markk/loeffler-h/src/sketch.ino

/*
 * Motor control for stepper half turns
 */

// motor pins
#define stepPin         9
#define dirPin          7
#define enablePin       5
#define alarmPin        3
#define sensorPin      11
#define ledPin         13
#define idmsbPin       A0
#define idlsbPin       A1

// speeds
#define pulseWidth      5 // microseconds
#define enableDelay    10 // milliseconds
#define halfTurnSteps 200 // steps for a half turn
#define accelSteps     90 // number of steps accelerating
#define decelLook      20 // start looking for sensor this many steps early
#define minPulse      412 // microseconds
#define maxPulse     2300 // microseconds

// duration correction
#define minimumDuration    50 // milliseconds
#define timedTurnMul        0.9907
#define timedTurnAdd       -8
#define durationGlissMul    0.9332
#define durationGlissAdd -283
#define doubleGlissMul      0.9144
#define doubleGlissAdd   -331
// pitch correction
#define glissAdd           -0.45

/*************************
 * communication commands
 *************************
 */
#define sAcknowledge    4
#define sAlarm          5
#define sReady          6
#define rEOM            0
#define rQuery          2
#define rTurn           3
#define rGliss          4
#define rTimedTurn      5
#define rDurationTurn   6
#define rDurationGliss  7
#define rForwards       8
#define rBackwards      9
#define rRecentre      10
#define rNoRecentre    11
#define rSetDuration   12
#define rReset         13
#define rDoubleGliss   14
#define rSetSustain    15
#define rTurnUntilNext 16
// array sizes
#define rDurlength      5
#define rLength        25
/*
 * ranges:
    21-39  set halfturns
    40-112 set startpitch
   120-192 set endpitch
   203-211 tests
 */

byte id;
char serialIncoming[rLength];
char newDuration[rDurlength];
char newSustainDuration[rDurlength];
int halfTurns;
long Duration;
long midDuration;
long sustainDuration;
float startPitch;
float midPitch;
float endPitch;
boolean Dir;
boolean reCentre;
volatile boolean alarmState = false;

void setup() {
    pinMode(stepPin, OUTPUT);
    pinMode(dirPin, OUTPUT);
    pinMode(enablePin, OUTPUT);
    pinMode(ledPin, OUTPUT);
    pinMode(alarmPin, INPUT_PULLUP);
    pinMode(sensorPin, INPUT_PULLUP);
    pinMode(idmsbPin, INPUT_PULLUP);
    pinMode(idlsbPin, INPUT_PULLUP);
    digitalWrite(dirPin, HIGH);
    digitalWrite(enablePin, LOW);
    attachInterrupt(digitalPinToInterrupt(alarmPin), setAlarm, CHANGE);
    Serial.begin(38400);
    findSensor(maxPulse);
    defaults();
    sendReady();
}

void setAlarm() {
    if (digitalRead(alarmPin) == LOW) {
        alarmState = true;
    } else {
        alarmState = false;
    }
}

void toggleEnable() {
    Serial.write(sAlarm);
    digitalWrite(ledPin, HIGH);
    digitalWrite(enablePin, HIGH);
    delay(enableDelay);
    digitalWrite(enablePin, LOW);
    while (alarmState) delay(enableDelay);
    digitalWrite(ledPin, LOW);
}

void defaults() {
    id = (digitalRead(idmsbPin) * 2) + digitalRead(idlsbPin);
    halfTurns = 1;
    Duration = 500;
    midDuration = 500;
    sustainDuration = 50;
    startPitch = 72;
    midPitch = 48;
    endPitch = 60;
    Dir = true;
    reCentre = true;
}

void sendReady() {
    Serial.write(sReady + id);
}

int pitchToPulse(float pitch) {
    /* map MIDI pitch to motor pulse duration */
    float i = pitch - 71;
    float p = 1 - log10((i / 51.035) + 1);
    return max(minPulse, (pow(p, 4.8) * 700) - 260);
}

float pitchbyteToMidi(byte pitch) {
    return (pitch / 2.0) + 36;
}

void oneStep(unsigned long pulseTime) {
    digitalWrite(stepPin, HIGH);
    delayMicroseconds(pulseWidth);
    digitalWrite(stepPin, LOW);
    while (pulseTime > 16383) {
        pulseTime -= 1000;
        delay(1);
    }
    delayMicroseconds(pulseTime - pulseWidth);
}

void findSensor(int pulse) {
    while(digitalRead(sensorPin) == LOW) {
        oneStep(pulse);
        if (alarmState) return;
    }
}

void turn(int halfturns, float pitch, bool dir) {
    int fullspeedsteps = (halfTurnSteps * halfturns) - (accelSteps * 2);
    int pulse = pitchToPulse(pitch);
    int startstoppulse = max(maxPulse, pulse);
    digitalWrite(dirPin, dir);
    delayMicroseconds(pulseWidth);
    for (int i=0; i<accelSteps; i++) {
        oneStep(map(i, 0, accelSteps, startstoppulse, pulse));
        if (alarmState) return;
    }
    for (int i=0; i<fullspeedsteps; i++) {
        oneStep(pulse);
        if (alarmState) return;
    }
    for (int i=0; i<accelSteps; i++) {
        oneStep(map(i, 0, accelSteps, pulse, startstoppulse));
        if (i>(accelSteps - decelLook) && digitalRead(sensorPin)) return;
        if (alarmState) return;
    }
    findSensor(startstoppulse);
}

void turnUntilNext(float pitch, bool dir) {
    int pulse = pitchToPulse(pitch);
    int startstoppulse = max(maxPulse, pulse);
    int accelsteps = map(pitch, 48, 72, accelSteps-10, accelSteps+10);
    digitalWrite(dirPin, dir);
    delayMicroseconds(pulseWidth);
    for (int i=0; i<accelsteps; i++) {
        oneStep(map(i, 0, accelsteps, startstoppulse, pulse));
        if (alarmState) return;
    }
    sendReady();
    while (Serial.available() == 0) {
        oneStep(pulse);
        if (alarmState) return;
    }
    for (int i=0; i<accelsteps; i++) {
        oneStep(map(i, 0, accelsteps, pulse, startstoppulse));
        if (alarmState) return;
    }
}

void gliss(int halfturns, float startpitch, float endpitch, bool dir) {
    int glisssteps = (halfTurnSteps * halfturns) - (accelSteps * 2);
    int startpulse = pitchToPulse(startpitch + glissAdd);
    int endpulse = pitchToPulse(endpitch + glissAdd);
    int accelsteps = map(startpitch, 48, 72, accelSteps-10, accelSteps+10);
    int decelsteps = map(endpitch, 48, 72, accelSteps-10, accelSteps+10);
    digitalWrite(dirPin, dir);
    delayMicroseconds(pulseWidth);
    for (int i=0; i<accelsteps; i++) {
        oneStep(map(i, 0, accelsteps, max(maxPulse, startpulse), startpulse));
        if (alarmState) return;
    }
    for (int i=0; i<glisssteps; i++) {
        oneStep(map(i, 0, glisssteps, startpulse, endpulse));
        if (alarmState) return;
    }
    for (int i=0; i<decelsteps; i++) {
        oneStep(map(i, 0, decelsteps, endpulse, max(maxPulse, endpulse)));
        if (i>(accelSteps - decelLook) && digitalRead(sensorPin)) return;
        if (alarmState) return;
    }
    findSensor(max(maxPulse, endpulse));
}

int timedTurn(int halfturns, long duration, bool dir) {
    // adjust duration
    duration = (duration + timedTurnAdd) * timedTurnMul;
    if (duration < minimumDuration)
        return 0;
    int fullspeedsteps = (halfTurnSteps * halfturns) - (accelSteps * 2);
    long acceltime = (long)maxPulse * (long)accelSteps;
    long turnduration = (duration * 1000L) - acceltime;
    long pulse = turnduration / (accelSteps + fullspeedsteps);
    int accelsteps = accelSteps;
    if (pulse > maxPulse) {
        accelsteps = 0;
        fullspeedsteps = halfTurnSteps * halfturns;
        pulse = (duration * 1000L) / fullspeedsteps;
    } else {
        pulse = max(pulse, minPulse);
    }
    digitalWrite(dirPin, dir);
    delayMicroseconds(pulseWidth);
    for (int i=0; i<accelsteps; i++) {
        oneStep(map(i, 0, accelsteps, maxPulse, pulse));
        if (alarmState) return 0;
    }
    for (int i=0; i<fullspeedsteps; i++) {
        oneStep(pulse);
        if (alarmState) return 0;
    }
    for (int i=0; i<accelsteps; i++) {
        oneStep(map(i, 0, accelsteps, pulse, maxPulse));
        if (i>(accelsteps - decelLook) && digitalRead(sensorPin)) return pulse;
        if (alarmState) return 0;
    }
    findSensor(maxPulse);
    return pulse;
}

long _durationGliss(long duration, float startpitch, float endpitch,
        int sustainstart, int sustainend, bool dir, bool recentre) {
    // adjust duration
    duration = (duration + durationGlissAdd) * durationGlissMul;
    if (duration < minimumDuration)
        return 0;
    int startsustainpulse = pitchToPulse(startpitch + glissAdd - 1);
    int startpulse = pitchToPulse(startpitch + glissAdd);
    int endpulse = pitchToPulse(endpitch + glissAdd);
    int endsustainpulse = pitchToPulse(endpitch + glissAdd - 1);
    int accelsteps = map(startpitch, 48, 72, accelSteps-10, accelSteps+10);
    int decelsteps = map(endpitch, 48, 72, accelSteps-10, accelSteps+10);
    long glisstime = ((duration - sustainstart) * 1000L) -
        (((max(maxPulse, startpulse) + startpulse) * (accelsteps / 2)) +
         ((endpulse + max(maxPulse, endpulse)) * (decelsteps / 2)));
    if (glisstime < (minimumDuration * 1000L))
        return 0;
    int glisssteps = glisstime / ((startpulse + endpulse) / 2);
    int sustainstartsteps = (sustainstart * 1000L) / startpulse;
    int sustainendsteps = (sustainend * 1000L) / endpulse;
    digitalWrite(dirPin, dir);
    delayMicroseconds(pulseWidth);
    // accelerando
    for (int i=0; i<accelsteps; i++) {
        oneStep(map(i, 0, accelsteps, max(maxPulse, startsustainpulse), startsustainpulse));
        if (alarmState) return 0;
    }
    // sustain start
    for (int i=0; i<sustainstartsteps; i++) {
        oneStep(startsustainpulse);
        if (alarmState) return 0;
    }
    // glissando
    for (int i=0; i<glisssteps; i++) {
        oneStep(map(i, 0, glisssteps, startpulse, endpulse));
        if (alarmState) return 0;
    }
    // sustain end
    for (int i=0; i<sustainendsteps; i++) {
        oneStep(endsustainpulse);
        if (alarmState) return 0;
    }
    // decelerando
    for (int i=0; i<decelsteps; i++) {
        oneStep(map(i, 0, decelsteps, endsustainpulse, max(maxPulse, endsustainpulse)));
        if (alarmState) return 0;
    }
    if (recentre) findSensor(max(maxPulse, endsustainpulse));
    return glisstime;
}

void durationTurn(long duration, float pitch, bool dir, bool recentre) {
    _durationGliss(duration, pitch, pitch, 0, 0, dir, recentre);
}

long durationGliss(long duration, float startpitch, float endpitch,
        bool dir, bool recentre, int sustain) {
    return _durationGliss(duration, startpitch, endpitch, sustain, sustain, dir, recentre);
}

long doubleGliss(long durationone, long durationtwo,
        float startpitch, float midpitch, float endpitch,
        int sustainstart, int sustainmid, int sustainend,
        bool dir, bool recentre) {
    // adjust durations
    durationone = (durationone + doubleGlissAdd) * doubleGlissMul;
    durationtwo = (durationtwo + doubleGlissAdd) * doubleGlissMul;
    if (durationone < minimumDuration || durationtwo < minimumDuration)
        return 0;
    int startpulse = pitchToPulse(startpitch + glissAdd);
    int midpulse = pitchToPulse(midpitch + glissAdd);
    int endpulse = pitchToPulse(endpitch + glissAdd);
    int accelsteps = map(startpitch, 48, 72, accelSteps-10, accelSteps+10);
    int decelsteps = map(endpitch, 48, 72, accelSteps-10, accelSteps+10);
    long glissonetime = ((durationone - sustainstart) * 1000L) -
        ((max(maxPulse, startpulse) + startpulse) * (accelsteps / 2));
    long glisstwotime = ((durationtwo - sustainstart) * 1000L) -
        ((endpulse + max(maxPulse, endpulse)) * (decelsteps / 2));
    if (glissonetime < (minimumDuration * 1000L) ||
            glisstwotime < (minimumDuration * 1000L))
        return 0;
    int glissonesteps = glissonetime / ((startpulse + midpulse) / 2);
    int glisstwosteps = glisstwotime / ((midpulse + endpulse) / 2);
    int startsustainpulse = pitchToPulse(startpitch + glissAdd - 1);
    int sustainstartsteps = (sustainstart * 1000L) / startsustainpulse;
    int midsustainpulse = pitchToPulse(midpitch + glissAdd - 1);
    int sustainmidsteps = (sustainmid * 1000L) / midsustainpulse;
    int endsustainpulse = pitchToPulse(endpitch + glissAdd - 1);
    int sustainendsteps = (sustainend * 1000L) / endsustainpulse;
    digitalWrite(dirPin, dir);
    delayMicroseconds(pulseWidth);
    // accelerando
    for (int i=0; i<accelsteps; i++) {
        oneStep(map(i, 0, accelsteps, max(maxPulse, startsustainpulse), startsustainpulse));
        if (alarmState) return 0;
    }
    // sustain start
    for (int i=0; i<sustainstartsteps; i++) {
        oneStep(startsustainpulse);
        if (alarmState) return 0;
    }
    // glissando one
    for (int i=0; i<glissonesteps; i++) {
        oneStep(map(i, 0, glissonesteps, startpulse, midpulse));
        if (alarmState) return 0;
    }
    // sustain mid
    for (int i=0; i<sustainmidsteps; i++) {
        oneStep(midsustainpulse);
        if (alarmState) return 0;
    }
    // glissando two
    for (int i=0; i<glisstwosteps; i++) {
        oneStep(map(i, 0, glisstwosteps, midpulse, endpulse));
        if (alarmState) return 0;
    }
    // sustain end
    for (int i=0; i<sustainendsteps; i++) {
        oneStep(endsustainpulse);
        if (alarmState) return 0;
    }
    // decelerando
    for (int i=0; i<decelsteps; i++) {
        oneStep(map(i, 0, decelsteps, endsustainpulse, max(maxPulse, endsustainpulse)));
        if (alarmState) return 0;
    }
    if (recentre) findSensor(max(maxPulse, endsustainpulse));
    return glissonetime + glisstwotime;
}

void test(int style) {
    if (style == 0) {
        // turn
        Serial.print("halfturns ");
        Serial.print(halfTurns, DEC);
        Serial.print(" pitch ");
        Serial.print(startPitch, DEC);
        Serial.print(" direction ");
        Serial.print(Dir, DEC);
        Serial.print(" time ");
        unsigned long starttime = millis();
        turn(halfTurns, startPitch, Dir);
        Serial.println(millis() - starttime);
    } else if (style == 1) {
        // gliss
        Serial.print("halfturns ");
        Serial.print(halfTurns, DEC);
        Serial.print(" startpitch ");
        Serial.print(startPitch, DEC);
        Serial.print(" endpitch ");
        Serial.print(endPitch, DEC);
        Serial.print(" direction ");
        Serial.print(Dir, DEC);
        Serial.print(" time ");
        unsigned long starttime = millis();
        gliss(halfTurns, startPitch, endPitch, Dir);
        Serial.println(millis() - starttime);
    } else if (style == 2) {
        // timed turn
        Serial.print("halfturns ");
        Serial.print(halfTurns, DEC);
        Serial.print(" duration ");
        Serial.print(Duration, DEC);
        Serial.print(" direction ");
        Serial.print(Dir, DEC);
        Serial.print(" time ");
        unsigned long starttime = millis();
        int pulse = timedTurn(halfTurns, Duration, Dir);
        Serial.print(millis() - starttime);
        Serial.print(" pulse ");
        Serial.println(pulse, DEC);
    } else if (style == 3) {
        // duration turn
        Serial.print("duration ");
        Serial.print(Duration, DEC);
        Serial.print(" pitch ");
        Serial.print(startPitch, DEC);
        Serial.print(" direction ");
        Serial.print(Dir, DEC);
        Serial.print(" recentre ");
        Serial.print(reCentre, DEC);
        Serial.print(" time ");
        unsigned long starttime = millis();
        durationTurn(Duration, startPitch, Dir, reCentre);
        Serial.println(millis() - starttime);
    } else if (style == 4) {
        // duration gliss
        Serial.print("duration ");
        Serial.print(Duration, DEC);
        Serial.print(" startpitch ");
        Serial.print(startPitch, DEC);
        Serial.print(" endpitch ");
        Serial.print(endPitch, DEC);
        Serial.print(" direction ");
        Serial.print(Dir, DEC);
        Serial.print(" recentre ");
        Serial.print(reCentre, DEC);
        Serial.print(" time ");
        unsigned long starttime = millis();
        long calcdur = durationGliss(Duration, startPitch, endPitch,
                Dir, reCentre, sustainDuration);
        Serial.print(millis() - starttime);
        Serial.print(" calctime ");
        Serial.println(calcdur, DEC);
    } else if (style == 5) {
        // double gliss
        Serial.print("midduration ");
        Serial.print(midDuration, DEC);
        Serial.print(", duration ");
        Serial.println(Duration, DEC);
        Serial.print("startpitch ");
        Serial.print(startPitch, DEC);
        Serial.print(" midpitch ");
        Serial.print(midPitch, DEC);
        Serial.print(" endpitch ");
        Serial.print(endPitch, DEC);
        Serial.print(" direction ");
        Serial.print(Dir, DEC);
        Serial.print(" recentre ");
        Serial.print(reCentre, DEC);
        Serial.print(" time ");
        unsigned long starttime = millis();
        long calcdur = doubleGliss(midDuration, Duration,
                startPitch, midPitch, endPitch,
                sustainDuration, sustainDuration, sustainDuration,
                Dir, reCentre);
        Serial.print(millis() - starttime);
        Serial.print(" calctime ");
        Serial.println(calcdur, DEC);
    } else if (style == 6) {
        // scale
        for (int i=48; i<73; i++) {
            long dur = 1500;
            Serial.print("pitch ");
            Serial.print(i, DEC);
            Serial.print(" duration ");
            Serial.print(dur, DEC);
            Serial.print(" time ");
            unsigned long starttime = millis();
            durationTurn(dur, i, i % 2, false);
            Serial.println(millis() - starttime);
            delay(500);
        }
    } else if (style == 7) {
        // arpeggio
        durationTurn(4000, 48, true, false);
        delay(1500);
        durationTurn(1800, 52, true, false);
        delay(1500);
        durationTurn(1800, 55, true, false);
        delay(1500);
        durationTurn(4000, 60, true, false);
        delay(1500);
        durationTurn(1800, 64, true, false);
        delay(1500);
        durationTurn(1800, 67, true, false);
        delay(1500);
        durationTurn(4000, 70, true, false);
        delay(1500);
        durationTurn(4000, 72, true, false);
    } else if (style == 8) {
        // show settings
        Serial.print("halfturns ");
        Serial.print(halfTurns, DEC);
        Serial.print(", midduration ");
        Serial.print(midDuration, DEC);
        Serial.print(", duration ");
        Serial.println(Duration, DEC);
        Serial.print("startpitch ");
        Serial.print(startPitch, DEC);
        Serial.print(", midpitch ");
        Serial.print(midPitch, DEC);
        Serial.print(", endpitch ");
        Serial.println(endPitch, DEC);
        Serial.print("direction ");
        Serial.print(Dir, BIN);
        Serial.print(", recentre ");
        Serial.print(reCentre, BIN);
        Serial.print(", sustain ");
        Serial.println(sustainDuration, DEC);
    } else {
        // show test styles
        Serial.println("203: 0xcb: turn");
        Serial.println("204: 0xcc: gliss");
        Serial.println("205: 0xcd: timedTurn");
        Serial.println("206: 0xce: durationTurn");
        Serial.println("207: 0xcf: durationGliss");
        Serial.println("208: 0xd0: doubleGliss");
        Serial.println("209: 0xd1: scale");
        Serial.println("210: 0xd2: arpeggio");
        Serial.println("211: 0xd3: show settings");
    }
    delay(333);
}

void processData() {
    for (byte i=0; i<rLength; i++) {
        byte data = serialIncoming[i];
        if (data == rEOM) {
            return;
        } else if (data == rQuery) {
            findSensor(maxPulse);
            sendReady();
        } else if (data == rTurn) {
            turn(halfTurns, startPitch, Dir);
        } else if (data == rGliss) {
            gliss(halfTurns, startPitch, endPitch, Dir);
        } else if (data == rTimedTurn) {
            timedTurn(halfTurns, Duration, Dir);
        } else if (data == rDurationTurn) {
            durationTurn(Duration, startPitch, Dir, reCentre);
        } else if (data == rDurationGliss) {
            durationGliss(Duration, startPitch, endPitch,
                    Dir, reCentre, sustainDuration);
        } else if (data == rForwards) {
            Dir = true;
        } else if (data == rBackwards) {
            Dir = false;
        } else if (data == rRecentre) {
            reCentre = true;
        } else if (data == rNoRecentre) {
            reCentre = false;
        } else if (data == rSetDuration) {
            for (byte d=0; d<rDurlength; d++) {
                newDuration[d] = serialIncoming[++i];
            }
            midDuration = Duration; // midDuration is previous Duration
            Duration = atol(newDuration);
        } else if (data == rReset) {
            defaults();
        } else if (data == rDoubleGliss) {
            doubleGliss(midDuration, Duration,
                    startPitch, midPitch, endPitch,
                    sustainDuration, sustainDuration, sustainDuration,
                    Dir, reCentre);
        } else if (data == rSetSustain) {
            for (byte d=0; d<rDurlength; d++) {
                newSustainDuration[d] = serialIncoming[++i];
            }
            sustainDuration = atol(newSustainDuration);
        } else if (data == rTurnUntilNext) {
            turnUntilNext(startPitch, Dir);
        } else if (data < 21) {
        } else if (data < 40) {
            halfTurns = data - 20;
        } else if (data < 113) {
            startPitch = pitchbyteToMidi(data - 40);
        } else if (data < 120) {
        } else if (data < 193) {
            midPitch = endPitch; // midPitch is previous endPitch
            endPitch = pitchbyteToMidi(data - 120);
        } else if (data < 203) {
        } else if (data < 212) {
            test(data - 203);
        }
    }
}

boolean receiveData() {
    static byte idx = 0;
    char rc;
    while (Serial.available() > 0) {
        rc = Serial.read();
        serialIncoming[idx] = rc;
        if (rc != rEOM) {
            idx++;
            if (idx >= rLength) idx = rLength - 1;
        } else {
            idx = 0;
            Serial.write(sAcknowledge);
            return true;
        }
    }
    return false;
}

void loop() {
    if (receiveData()) {
        processData();
        if (alarmState) toggleEnable();
        sendReady();
    }
}
