markk/loeffler-h/(commit log)

2017-10-01 Working prototype
    [score.csv]
2017-10-11 Five motor modes working
2017-10-12 Make SC:arduino interface
2017-10-14 Enter sketch scores
    [score.csv]
2017-10-15 Do actions at the current tempo
2017-10-15 Arduino sends ID when asked
2017-10-16 Add support for four arduinos
    [score.csv]
2017-10-16 Add schematic diagram
2017-10-18 Change arduino pin numbers for neater wiring
2017-10-20 Change score "l" to "r"
    [score.csv]
2017-10-21 Shorten decelleration to be sure of finding sensor
    [sketch.ino]
2017-10-21 Change tests to use current settings instead of random
2017-10-21 Look for sensor earlier rather than shorten decel
    [sketch.ino]
2017-10-25 Enter page 1
    [score.csv]
2017-10-31 Make doublegliss arduino function
2017-10-31 Match pitch of durationturn and durationgliss
2017-10-31 Enter section bars 258-293
    [score.csv]
2017-11-01 Don't look for sensor early in duration functions
2017-11-01 Improve pitch mapping
2017-11-02 Remove score from VCS
    [score.csv]
2017-11-12 Build also for Arduino Nano 328
2017-11-12 Remove builtin LED code which shares sensor pin
2017-11-12 Lower sustain pitch at end of gliss
2018-03-23 Tidy and improve durationgliss.
    Add separate doublegliss function to avoid calculation time hiccup
    [sketch.ino]
2018-03-30 Change pin numbers for A-Star 32U4
2018-03-30 Update schematic diagram
2018-03-30 Add interrupt to alarmPin
2018-04-03 Adjust alarm interrupt action, main loop
2018-04-03 Change arduino→driver cable colours
2018-04-07 Add GUI buttons showing arduino ready state
2018-04-11 Adjust duration correction factors with SC timing
    [sketch.ino]
2018-04-11 Fine-tune duration adjustments, avoid integer overflow
    [sketch.ino]
2018-04-11 Init non-verbose by default, show arduino state in GUI
2018-04-11 Add score to git
    [score.csv]
2018-04-25 Return after finding sensor early
2018-04-25 Start assembly documentation
2018-04-25 Adjust decelLook to avoid extra rotation
    [sketch.ino]
2018-05-06 Correct bolt size
2018-05-06 Add check for sensor alignment
2018-05-07 Add note about sensor alignment
2018-10-30 Change doubleglisses at bar 301 to avoid minimum duration
    [score.csv]
2018-10-30 Revert "Change doubleglisses at bar 301 to avoid minimum duration"
    This reverts commit 08c0154e1cc2f9b449e4867d355e9cb05e430068.
    [score.csv]
2018-10-30 Join motor 2 glisses bar 301
    [score.csv]
2018-11-04 Score fixes bars 310-337
    [score.csv]
2018-11-05 Score fix bar 330
    [score.csv]
